pacelalli/Juke-2.0/README.md

# Juke-2.0
The new Jukebox Dancing Robots
