pacelalli/Juke-2.0/Planning.md

SEANCE 2:  
Travail sur le code des roues omniwheel (déplacements latéraux, rotations...) pour la danse du robot.  
Comment séléctionner une chanson (avec la molette) et la jouer (avec le lecteur mp3:les enceintes). 
Et demander prof commander boule disco  

SEANCE 3:  
Comment déplacer un pixel de lumière sur la barre LED avec la molette (séléction des chansons).  
Mettre en place le code pour le mouvement des bras avec les servomoteurs.  

SEANCE 4:  
Travail sur le mouvement de la tête avec la boule disco (commandée par un servomoteur.  
la tête pourra faire des tours à 360°, ou des petis déplacements selon un certain angle.  

SEANCE 5:  
Travail sur le code des chorégraphies: une chorégraphie par chanson, donc 6 chorés différentes!  
Les chorégraphies comprendront des mouvements de bras, de tête (boule disco) et du corps (rotations...): faire de fonctions pour chaque chorégraphie.  
et caisson de résonnance pour les basses.  

SEANCE 6:  
Commencer à travailler la forme:  
des bras à l'imprimate 3D.  
un corps cylindrique en plastique (vieux seau ou pot de peinture).  
la tête boule disco (commandée par un servomoteur); mettre des yeux (et donc déterminer une position d'origine de la tête pour que le robot regarde devant lui au début).  

SEANCE 7:
Forme du robot:   
un socle plus haut que le chassis pour placer les servomoteurs de la tête et des bras (voir schéma du compte rendu 1).  
Découpages de pièces : plastique pour le corps, imprimante 3D pour les bras.  
Assemblage. 

SEANCE 8:  
Finitions ésthétiques :  
Ressemblance avec R2D2, éléments blancs et bleu, décorations, dessins, lumières!  
Tests du bon fonctionement de tous les éléments.
