pacelalli/Juke-2.0/Rapports séances/Séance8/Rapport séance 8.docx

Rapport séance 8

Aujourd’hui on a pu peaufiner notre projet, comme toujours il a fallu revoir les branchement et resouder certains fils. Puis on a pu le fermer définitivement.

On a commencé à s’entrainer à présenter notre projet et à faire le PowerPoint.
