pacelalli/Juke-2.0/Rapports séances/Séance6/Rapport séance 6.docx

Rapport séance 6

Aujourd’hui j’ai terminé le code qui contient le bouton rotatif le ruban led et les enceintes.

On a changé de carte Arduino (uno a mega) car on a trop de câbles. J’ai du en resouder aussi.

J’ai recoupé au cutter la partie en plastique pour que ça rentre bien dans le socle.
