pacelalli/Juke-2.0/Cahier Des Charges.md

Cahier des charges : Projet Arduino
« Jukebox 2.0 »

Contexte du projet :
Le but de ce projet est d’égayer la journée des gens qui le croisent, en apportant la bonne humeur, ou pourquoi pas de la nostalgie, mais toujours en mettant l’ambiance !

Objectif du projet :
Créer un robot permettant de jouer une musique demandée (type jukebox) et qui peut danser en fonction de la musique choisie.

Comment :
Le robot proposera une musique connue par genre musical (pour un total de 6 musiques), par l’intermédiaire de boutons sur lui (comme un jukebox).
Une fois la musique choisie par l’utilisateur, le robot lance la musique (un extrait, pas dans son entièreté) et il performera une petite chorégraphie en rapport avec la musique jouée (dans la mesure du possible : il peut tourner rapidement sur lui-même lorsqu’il joue une musique de rock, et faire de plus petits déplacements pour un slow…)

Détails du robot :
Il pourrait posséder une boule à facettes sur le dessus.
Support : des roues (pour le déplacement), donc des moteurs !
Un système sonore intégré.
