pacelalli/Juke-2.0/Rapports séances/Séance7/Rapport séance 7.docx

Rapport séance 7

Aujourd’hui j’ai continué à faire des branchements, certains fils se sont encore dessoudés donc je les ai resoudé.

J’ai aussi construit un support pour mettre les piles.
