pacelalli/Juke-2.0/Rapports séances/Séance5/Rapport séance 5.docx

Rapport séance 5

Aujourd’hui on est allé demander au monsieur des imprimante 3D de lancer l’impression de notre socle.

On a eu plusieurs problèmes de câblages donc je suis aller au fablab pour resouder des connexions (moteur/bouton rotatif)

J’ai commencé à lier le programme du bouton et du ruban LED au programme de l’enceinte.

J’ai posé plein de questions a M Masson qui a réussi a me débloquer a chaque fois, il est très gentil 😊
