pacelalli/Juke-2.0/Rapports séances/Séance4/Compte rendu séance 4.docx

Compte rendu séance 4

Aujourd’hui j’ai commencé a fixé les composant a notre base (perceuse + visse)

J’ai essayé de coordonne le choix des musiques avec le bouton rotatif mais on arrive plus à faire marche les enceintes.

On a fait notre présentation (il a fallu refaire tous les branchements des systèmes qui sont déjà fonctionnel) et répondu aux questions pendant 10 min.

J’ai continué de travailler sur le code des servo moteurs.
