pacelalli/Juke-2.0/Rapports séances/Séance3/Compte rendu séance 3.docx

Compte rendu séance 3

Aujourd’hui j’ai commencé à m’intéresser à savoir comment aller être fait le corps de notre robot.

J’ai récupéré une plaque de plexiglass assez fine que j’ai coupé au cutter au bonne dimension (68 de longueur et 20 de hauteur pour pouvoir l’enrouler et créer ainsi un cylindre.

On a aussi récupéré la boule disco et j’ai schématisé un socle qui viendra se fixer dans la structure en métal donnée et qui servira d’isolent entre les L298 et le métal et qui servira aussi de base au cylindre. Je suis ensuite aller voir M. Lebreton qui a pu découper dans une plaque de bois le socle.

Il n’était pas très bien réalisé, il a donc fallu agrandir les trous à la perceuse.

J’ai oublié de prendre des photos, je les rajouterais après la prochaine séance.
