pacelalli/Juke-2.0/Rapport final + schéma elec/Rapport de projet Arduino (Lalli-Pacini).pdf

# Rapport de

## PROJET ARDUINO 2023

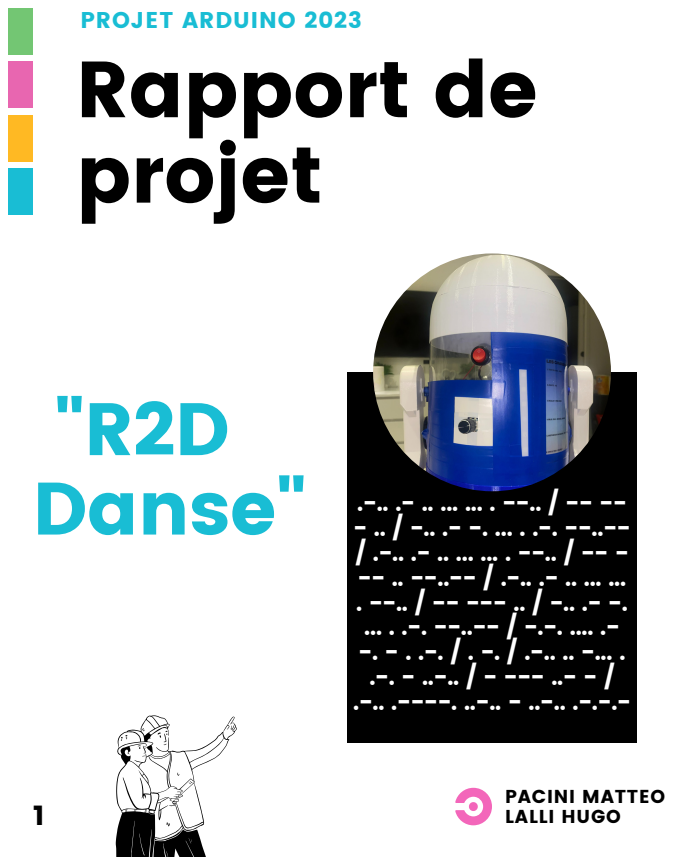
[picture p12: page 1]
projet; "R2D Danse; PACINI MATTEO LALLI HUGO

# Sommaire

## Un objectif respecté | 3

## Plannings | 7

Algorithme de fonctionnement ..... 5

## Conclusion et perspectives | 9

## Schéma électrique | 4

## Problèmes et résolution | 8

## Coût du projet | 6

SDG PROGRESS REPORT 2020

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
## 08 Bibliographie | 10

Attentes et objectifs :
Au départ, nous avions l'idée d'amuser les gens, avec un projet qui s'adresse à tout type de personne, en apportant bonne humeur et nostalgie. Ainsi, nous voulions fabriquer un robot qui puisse jouer de la musique (jukebox) et danser en fonction de cette dernière. Il permettrait de jouer 6 chansons, et proposerait 6 chorégraphies différentes (1 pour chaque style). Ces chorégraphies consisteraient en des déplacements au sol (roues) et des mouvements de bras (servomoteurs).

Esthétique et fonctionnement :
Nous avons fait une esquisse au début du projet, afin de savoir vers quoi nous devions nous diriger. Alors, le robot serait de forme cylindrique (style R2D2) avec un menu des chansons écrit (papier) et un choix possible grâce à un encodeur rotatif et des leds. Nous hésitions entre le fait de faire la tête en forme de boule disco, ou de simplement l'accrocher à l'intérieur du robot. Comme on peut voir ci-dessous, nous avons opté pour la deuxième option, c'est pourquoi le cylindre est transparent.

# 1.Un objectif respecté

3

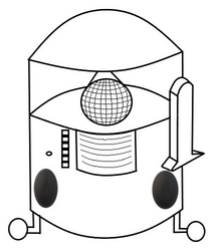
[picture p13: figure]
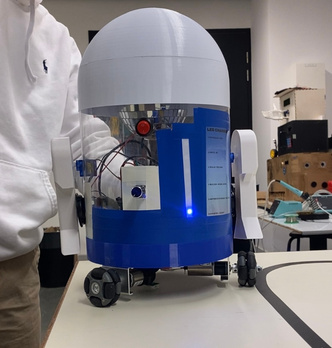
[picture p14: figure]

Ainsi, les 6 chansons sont stockées sur une micro SD, et numérotées de 1 à 6. Alors, grâce au lecteur micro SD, on peut sélectionner une chanson par son numéro, et les jouer sur la sortie audio (ici deux enceintes).
Lorsqu'une chanson sera jouée, le code fera appel à une fonction de chorégraphies (danses prédéfinies), qui elle même fera appel aux servomoteurs (mouvement des bras), et aux trois moteurs 12V pour déplacer le robot au sol.
Pour le son, le réglage se fait à l'aide d'un amplificateur qui se trouve sur le cylindre du robot.

On peut voir avec les deux photos, que nous nous sommes plutôt bien rapprochés du résultat attendu, l'objectif est bien respecté !

# 2. Le schéma électrique

4

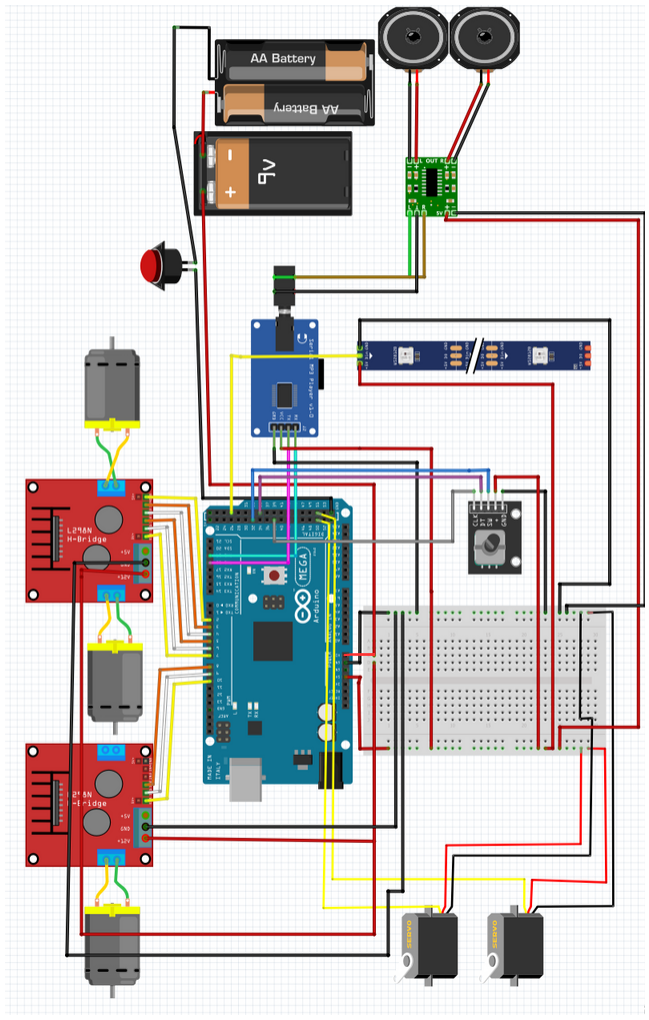
[picture p15: figure]

Fichier Fritzing dans le Github !

# 3. Algorithme de fonctionnement

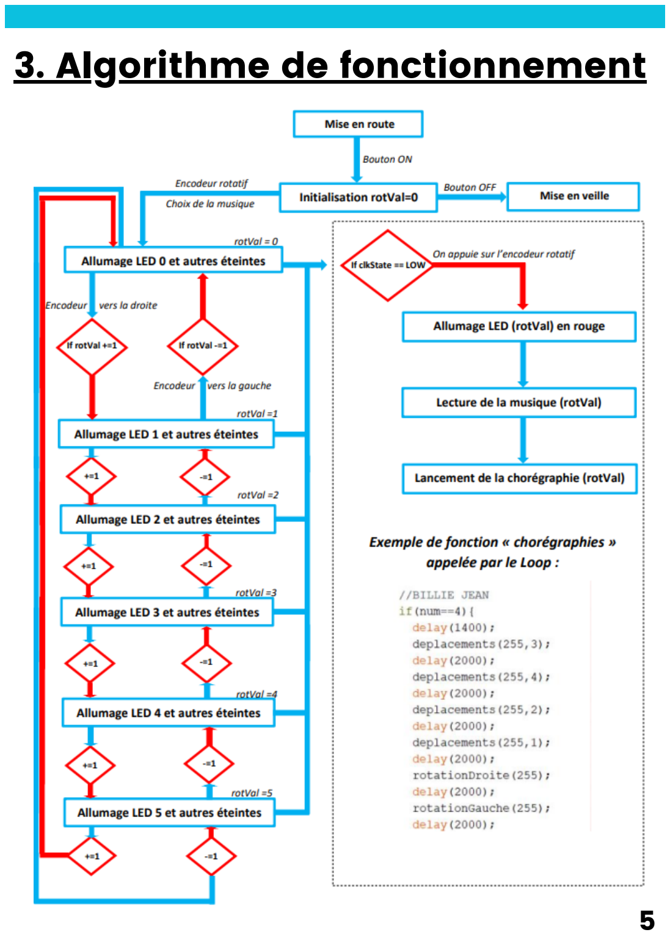
[picture p16: page 5]

5

24h/personne en cours (8 cours de 3 heures);
15h/personne en plus en parallèle (FabLab, code à la maison); 3h/personne pour le rapport.

Coût du matériel :
Voici un tableur qui nous a permis de faire la liste de tous les composants utilisés dans notre robot avec leur prix correspondant. Nous avons chercher les prix sur les sites suivant : Amazon, E-Bay et AliExpress, et avons comparé les 3 sites pour choisir les prix les plus convenables, et les plus réalistes.

Coût de la main d'œuvre :
Nous sommes partis d'un salaire brut annuel de 38k euros pour 1600h de travail, ce qui correspond à un salaire de 23,75 euros l'heure.
Ainsi, nous avons estimé notre temps de travail total à 42 heures par personne :

On obtient alors un coût ingénieur de :
42x23,75x2 (car 2 personnes) = 1995 euros

Coût total :
On obtient finalement un coût total pour ce projet de : 1995 +171,5 = 2166,5 euros.

# 5. Coût du projet

6

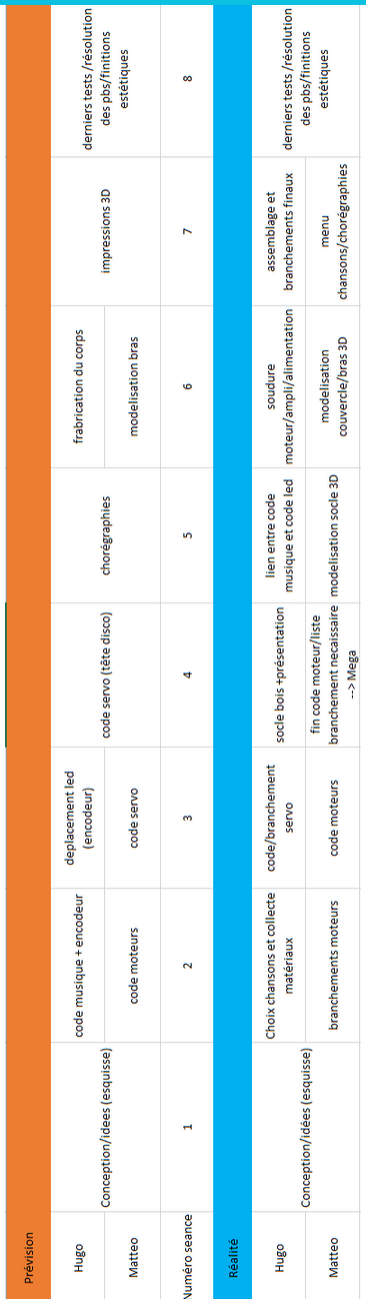
[picture p17: figure]

# 6. Plannings

7

Premièrement, la boule disco étant trop lourde, celle-ci a cassé le crochet, on a donc mis du scotch pour tenir jusqu'à la présentation...

Puis, les bras (servomoteurs) tremblaient car il y avait un problème de tension, et car les bras (pièces 3D) étaient plutôt lourds pour de tels moteurs.

Et, le dernier problème venait des chorégraphies. Effectivement, la musique et les déplacements correspondants s'arrêtaient sans raisons, ce qui venait probablement du code, mais nous n'avons pas pu le vérifier.

Bonus : JUL n'était pas apprécié de tout le jury....

Durant tout le déroulé du projet, nous avons rencontré de nombreux problèmes, certains prévisibles, et d'autres non, qui sont survenus à la dernière minute...

Le premier problème était un problème de soudure au niveau d'un moteur. Et donc, pendant les premières séances, nous ne le savions pas, et avons eu du mal à programmer le code des moteurs et donc le déplacement des roues : le problème pouvait venir des branchements, du code, d'un manque d'alimentation...
Une fois détecté, il fallait simplement souder.

Puis, lors de l'impression du couvercle en 3D, il y a eu un décalage qui nous a contraint à couper la pièce puis à la recoller.

Enfin, pendant la dernière séance, de nombreux problèmes sont apparus :

# 7. Problèmes et résolution

8

Résoudre les derniers problèmes.

Faire plus de chorégraphies ou des chorégraphies plus élaborées.

Améliorer le système sonore (plus d'enceintes, des caissons).

Télécommande + module Bluetooth pour le commander à distance.

Synchroniser notre projet avec celui de Benjamin Choiselat et Vahan Komarian, pour faire de la lumière en fonction de la musique et la refléter à l'aide de la boule disco.

En conclusion, ce projet nous a permis de nous mettre en condition d'entreprise, et donc de mener à bien un projet en un temps donné. Comme expliqué dans la précédente slide, nous avons dû faire face à des problèmes inattendus et complexes souvent au dernier moment, que nous avons pu résoudre en autonomie.

Ainsi, cette expérience nous a enrichi et nous a permis de développer nos capacités à travailler en groupe, à s'écouter et s'entraider.

C'est assez satisfaisant sur le plan personnel de partir d'une simple idée, d'un dessin, et d'arriver à concrétiser cette idée avec un peu d'imagination, et surtout de l'adaptation et de la recherche. En effet, lors de la présentation orale, le projet était abouti et nous convenait, même si avec plus de temps, on aurait pu faire encore plus de chose et mieux le faire fonctionner.

Et oui ... Avec plus de temps, on aurait pu :

# 8. Conclusion et perspectives

9

Pour conclure, voici une liste des sites et forums qui nous ont servi pour résoudre des problèmes, comprendre des composants et leur codage, faire le schéma électrique...

Fritzing Forum (schéma du projet):
https://forum.fritzing.org/

Site de Pascal MASSON pour comprendre les composants :
Pascal MASSON - Enseignement (unice.fr)

Site pour code de l'encodeur rotatif : https://www.aranacorp.com/fr/utilisation-dun-encodeur-rotatif-avec-arduino/

Site pour les servomoteurs :
[GUIDE] Arduino Comment contrôler servomoteur + code, câblage (arduino-france.site)

MERCI !

# 9. Bibliographie

10
