pacelalli/Juke-2.0/Rapports séances/Séance7/Compte Rendu Pacini_Matteo_16_02.pdf

# Compte Rendu séance 7 PROJET :

## « Jukebox Dancer »

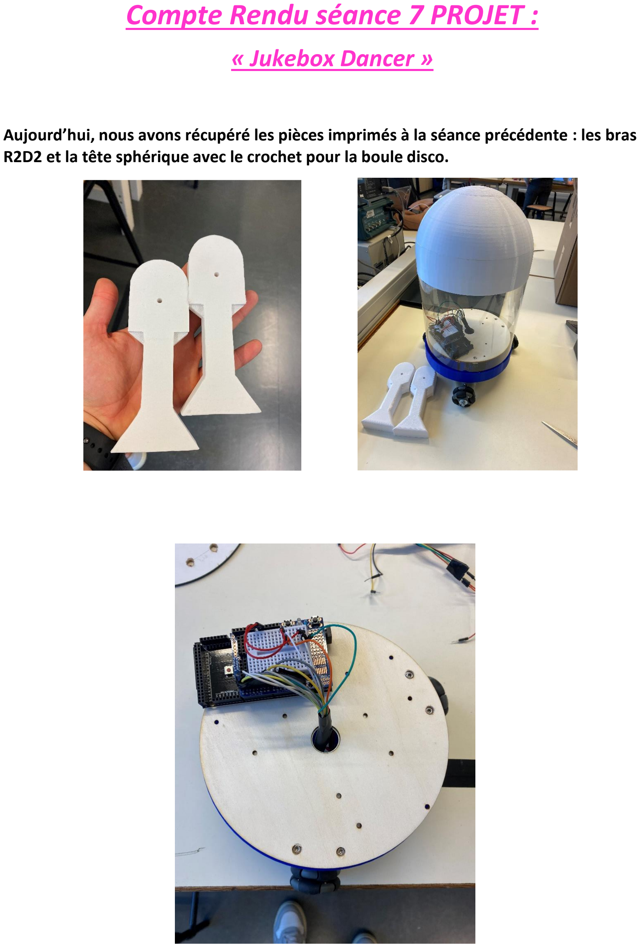
[picture p18: page 1]

Aujourd’hui, nous avons récupéré les pièces imprimés à la séance précédente : les bras R2D2 et la tête sphérique avec le crochet pour la boule disco.

Puis, comme on peut voir sur la photo ci - dessus , j’ai séparé la partie L298 + Moteurs du reste pour permettre de pas mélanger tous les fils. En effet, nous n’avions plus besoin d’accéder à cette partie car nous avons terminé la partie code + branchements de la base du robot. Ainsi, j’ai sorti tous les fils par le trou du socle en bois, que j’ai scotchés et branchés sur la carte, afin de ne pas les enlever lorsqu’on manipule d’autres composants.

Enfin, code des chorégraphies concernant les moteurs : c-à-d que j’ai codé tous les déplacements des 6 chansons !

Il reste à coder le mouvement des bras (SERVOMOTEURS) !
