pacelalli/Juke-2.0/Rapports séances/Séance2/Compte Rendu Pacini_Matteo_19_12.pdf

# Compte Rendu séance 2 PROJET :

## « Jukebox Dancer »

Durant cette deuxième séance de projet, nous avons réussi à faire ce que nous avions convenu sur le planning. Hugo s’est occupé de la barre LED avec l’encodeur rotatif (voir son compte rendu) et je me suis occupé du code sur les moteurs qui contrôlent les roues omniwheel.

Ainsi, j’ai pu faire le branchement du L298 sur 2 des 3 moteurs (il nous restera juste à brancher un deuxième L298 pour le moteur numéro 3 qui nous permettra d’obtenir une vitesse de rotation plus importante (pour les chorégraphies qui sont plutôt rapides)).

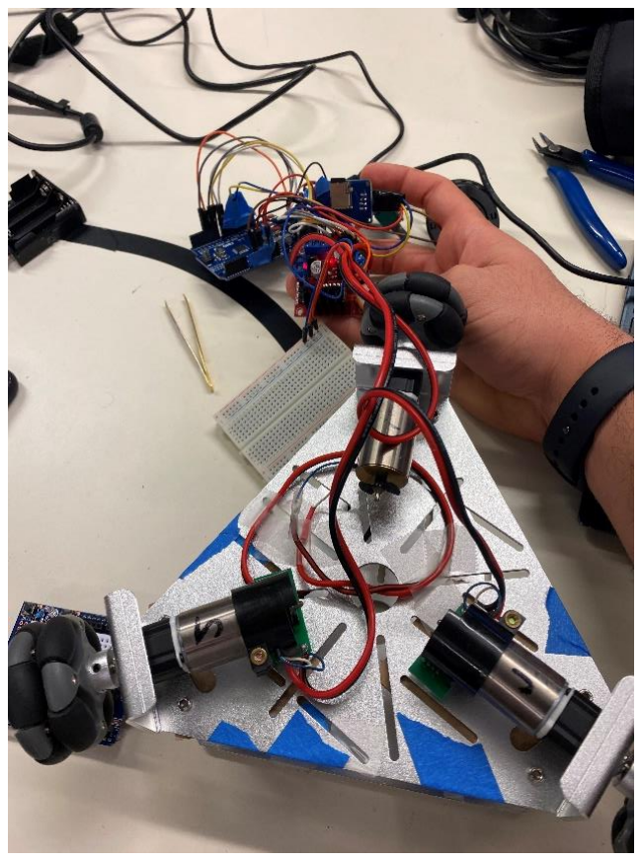
[picture p27: figure]
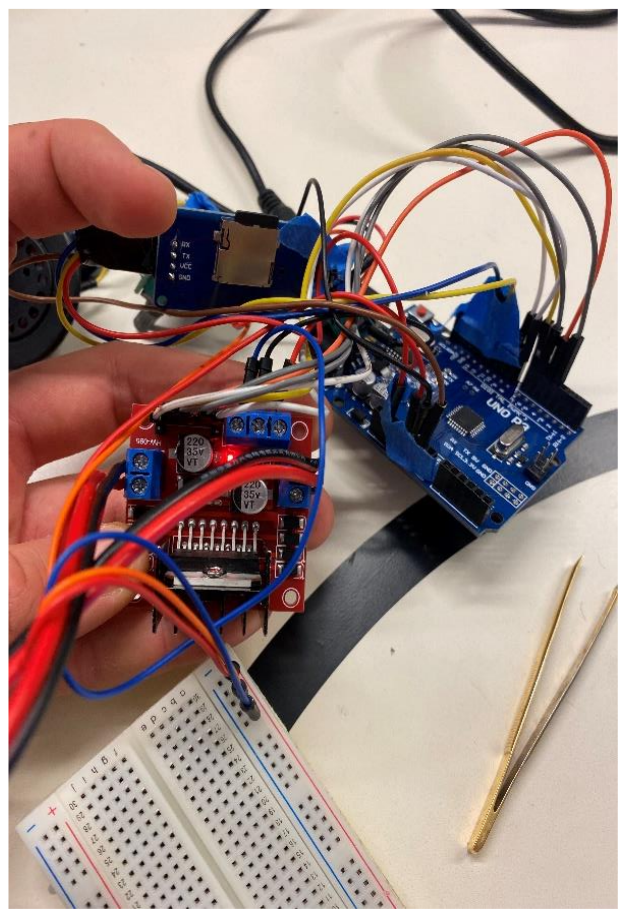
[picture p28: figure]
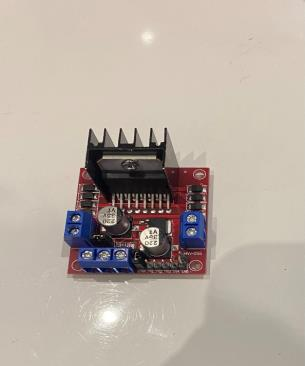
[picture p29: figure]

Pour les branchements, j’ai suivi les instructions du cours sur les moteurs, et j’ai pu récupérer le code fournit page33 du cours, que j’ai un peu moduler en fonction des entrées choisies.

Ainsi, j’ai créé des fonctions avancer, reculer, rotationDroite et rotationGauche qui prennent en paramètre une vitesse de rotation des roues, alors nous aurons juste à placer ces fonctions dans les méthodes des danses, avec le paramètre adéquat.

Il suffit d’indiquer un sens de rotation pour chaque moteur en début de fonction (par exemple les moteurs ne tourneront pas dans le même sens lors d’une rotation : un dans un sens, un dans l’autre, mais à la même vitesse pour pouvoir faire du sur place).

C’est ce que j’ai fait pour chaque fonction, on peut voir sur le code, à l’aide des commentaires, que j’ai indiqué le sens de rotation (direction) des moteurs (normale étant pour la marche avant et inverse pour reculer).

Voir fonctions sur la page suivante !

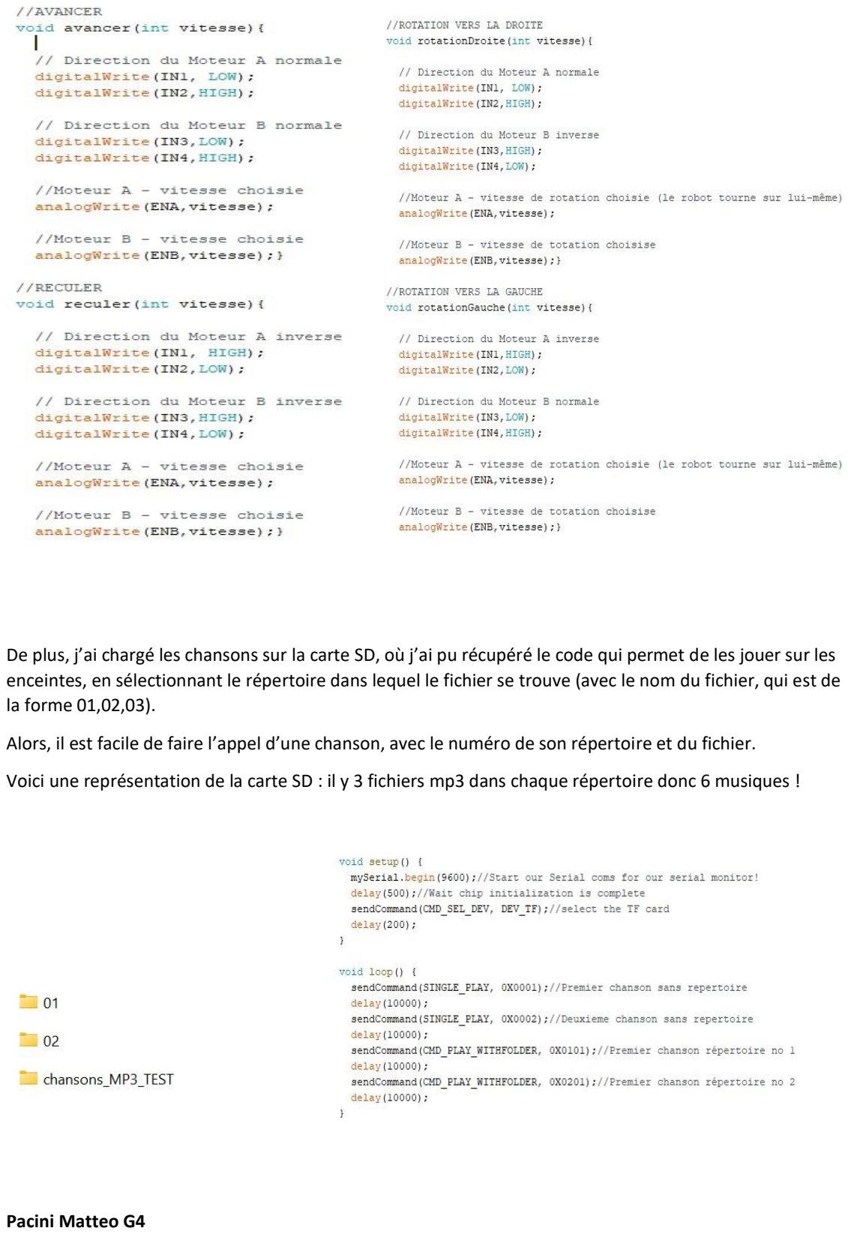
[picture p30: page 2]

De plus, j’ai chargé les chansons sur la carte SD, où j’ai pu récupéré le code qui permet de les jouer sur les enceintes, en sélectionnant le répertoire dans lequel le fichier se trouve (avec le nom du fichier, qui est de la forme 01,02,03).

Alors, il est facile de faire l’appel d’une chanson, avec le numéro de son répertoire et du fichier.

Voici une représentation de la carte SD : il y 3 fichiers mp3 dans chaque répertoire donc 6 musiques !

Pacini Matteo G4
