pacelalli/Juke-2.0/(list of files, drawings)

Other design files:
Rapport final + schéma elec/Schéma final.fzz
