pacelalli/Juke-2.0/(commit log)

2022-12-11 Create Cahier Des Charges
2022-12-12 Update and rename Cahier Des Charges to Cahier Des Charges.md
2022-12-12 Update Cahier Des Charges.md
